phoenixuprisingactual-star/emg-hand/tripod_claw_v1.stl

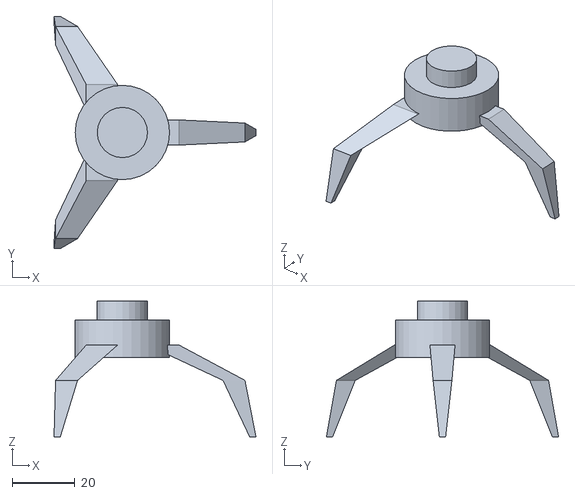
[picture p1: CAD file, 2026-10-16]
tripod_claw_v1.stl
64.2 x 73.9 x 43.2
