phoenixuprisingactual-star/emg-hand/(commit log)

2026-10-16 README: recast bench bring-up step 0 as project fact (CH340 driver), drop personal status note
2026-10-16 README: banner recast (facts preserved), design/wiring references now resolve in-repo
2026-10-16 Add Phase 1 claw control design doc (cited by README and emg_control.h)
2026-10-16 Add wiring schematic (cited by README and firmware headers) - DRAFT, design review only
2026-10-16 Add tripod claw generator script (output path made script-relative)
2026-10-16 Add tripod claw v1 STL - DRAFT, untested geometry (see design doc)
    [tripod_claw_v1.stl]
2026-10-16 Add board-only smoke test sketch (Uno + PCA9685, no servos)
2026-10-16 Add board smoke test README (public distillation of the staging checklist)
2026-10-16 README banner: electrodes arrived Oct 15 (in hand); EMG sensor still arrives Oct 17
2026-10-16 Schematic: scrub em dashes
2026-10-16 Board smoke README: scrub em dashes
2026-10-16 board_smoke.ino: scrub em dashes in comments
2026-10-17 Fix first AVR compile: include stdint.h instead of cstdint (avr-gcc has no cstdint)
    [emg_control.h]
