phoenixuprisingactual-star/emg-hand/(notices)

Notices in the files:
README.md:
License: MIT
Design license: CERN-OHL-S v2
